ndbre/dirtt/Site/Circle_green.png

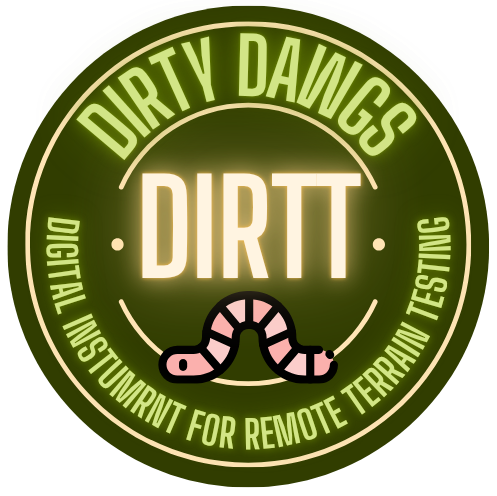
Site/Circle_green.png
