ndbre/dirtt/Site/Circle_blue.png

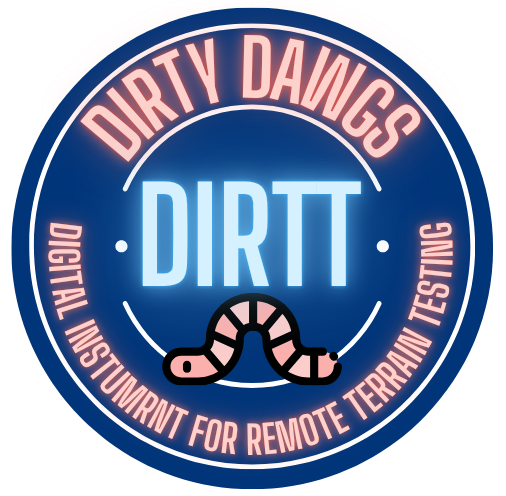
Site/Circle_blue.png
