ndbre/dirtt/PDR/2026-09-12_PDR.pptx

## D.I.R.T.T

Digital Instrument for Remote Terrain Testing

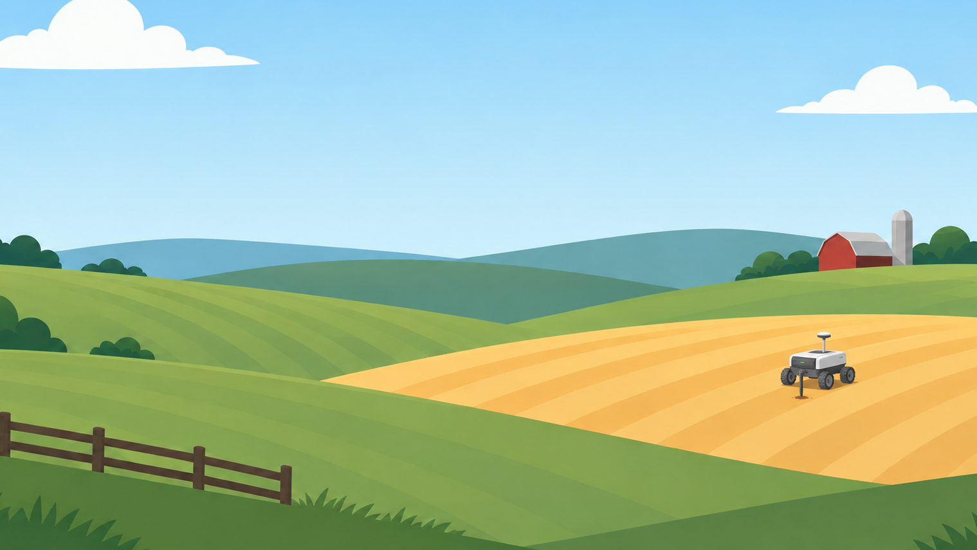
[picture p29: figure]

An affordable, autonomous robot that collects and analyzes soil samples across crop fields.

## Team Members

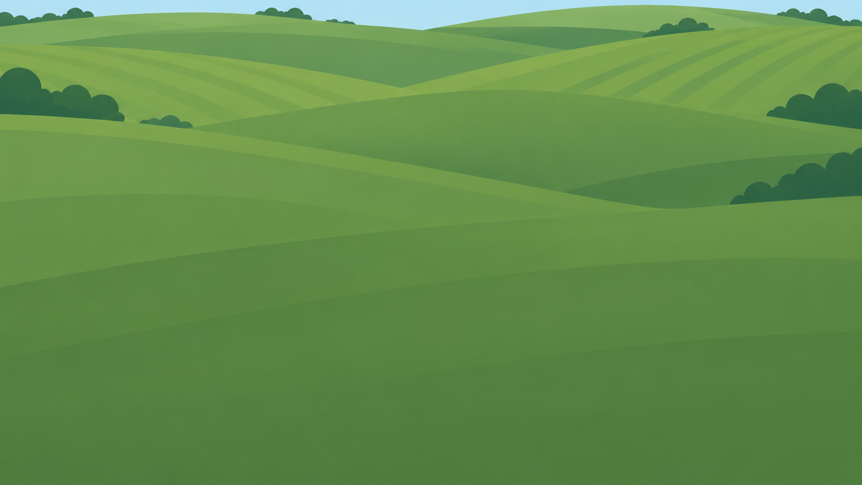
[picture p30: figure]

Nolan Brechtel
Project Manager | Navigation Lead

George Utz
Chief Scientist | Power & Charging Lead

Cara Belew
Data Backup & Control Lead

Zachary Morrow
Soil Testing Lead

Rebecca Ueltschey
Drivetrain Lead

Dr. Chrsitopher Hudson
Faculty Advisor

## The Problem

Who We Help

Agricultural Research Labs
Need affordable, autonomous sampling to reduce technician hours in the field
Independent Farms
Need reliable soil data without the high cost of existing robots
Field Technician
Need to reduce repetitive, manual sampling work

25,000
$41B
49%

people die from every day, including more than 10,000 children [1]

gap between U.S. agricultural imports and exports each [2]

of U.S. crop fields show poor health or nutrient imbalance [3]

## The Problem

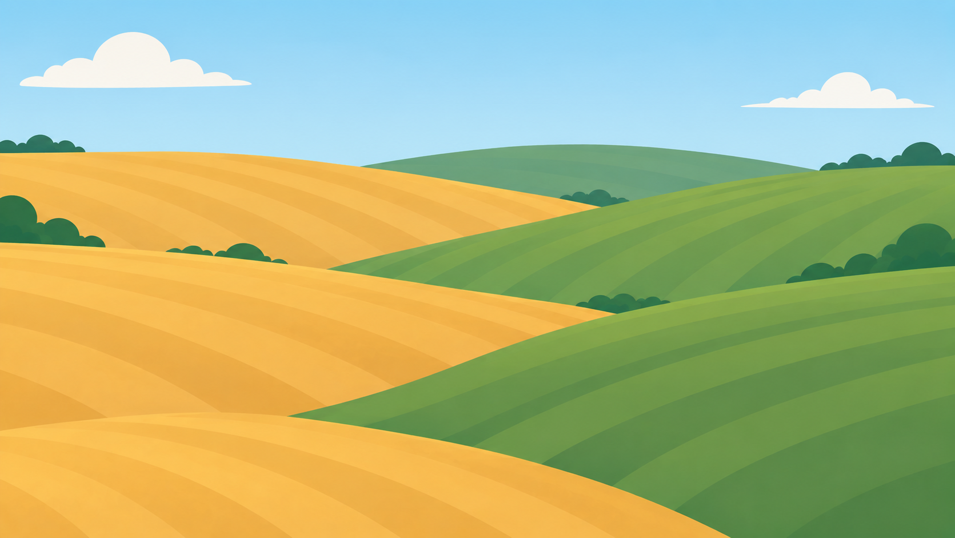
[picture p31: figure]

Who We Help

Agricultural Research Labs
Need affordable, autonomous sampling to reduce technician hours in the field
Independent Farms
Need reliable soil data without the high cost of existing robots
Field Technician
Need to reduce repetitive, manual sampling work

25,000
$41B
49%

people die from every day, including more than 10,000 children [1]

gap between U.S. agricultural imports and exports each [2]

of U.S. crop fields show poor health or nutrient imbalance [3]

## Slide 5
