ndbre/dirtt/PS/2026-09-14_PS.docx

# 1. PROBLEM STATEMENT

Soil health is critical to the growth of healthy crops, and knowing what nutrients are lacking is necessary to correct for deficiencies. D.I.R.T.T. is an autonomous soil testing robot that allows users to understand what they have in their dirt, thereby allowing them to properly address any issues.

## 1.1. Need Statement

Approximately 25,000 people, including more than 10,000 children, die each day from hunger and related causes [1]. In 2025, U.S. agricultural imports exceeded agricultural exports by $41 billion [2]. Meanwhile, farmers reported at least one soil or water resource concern on 49% of surveyed soybean, oat, cotton, and wheat fields [3]. Agricultural soil testing traditionally requires numerous individual soil cores to produce a representative composite sample. Depending on the sampling methodology, extension services generally recommend collecting approximately 10–20 cores from each management area or zone [4]. Improper sampling location, depth, or technique can produce unrepresentative samples and consequently inaccurate soil-test recommendations [5]. The labor required to manually collect these samples creates an opportunity for automated soil-sampling systems to improve sampling consistency and reduce the time personnel spend performing repetitive field collection tasks.

## 1.2. Background and Related Work

Soil health is normally evaluated by measuring nutrient levels, such as NPK and pH. Nutrient sensing relies on ion-selective electrodes (ISEs), while pH is measured using a similar ion-selective electrode immersed in a soil solution. Traditionally, soil testing is done manually, which is slow and labor-intensive across large farmlands. Autonomous systems have been developed to address this: Rogo's SmartCore follows a pre-programmed grid, covering about 500 acres in five hours while reducing sampling variability by at least 10% [6], [7]. Agrobot Lala uses satellite imagery and AI to select sampling zones, then autonomously extracts and analyzes each sample for nitrates on-site in about 30 minutes [8].

The needed device shares values with both systems: autonomous, GPS-guided navigation to sampling locations, but differs in how it divides the work and how it's powered. Rogo demonstrates fast, reliable autonomous sampling, but all analysis is done in an off-site lab and runs on diesel [6], while Lala demonstrates in-field analysis but at a slower pace [8]. This project design combines navigation, sampling, and on-board analysis in a single solar-powered unit, positioning it as a lower-cost, fuel-independent alternative that avoids emissions, refueling, and operating costs of larger vehicles. Existing designs, such as ISE-based nitrate probes with protective membranes for field insertion [9], [11], and multi-ion electrode arrays with defined response times and service life [10], establish practical approaches that may be helpful for this design.

Together, this research confirms that both autonomous navigation and in-field nutrient sensing are established approaches. The next section translates these findings into concrete Design Requirement Specifications, defining the specific performance, sampling, analysis, and power criteria the device must meet.

## References

[1] United Nations, "Losing 25,000 to hunger every day," UN Chronicle, vol. 45, no. 2–3, Jun. 2008. [Online]. Available: https://www.un.org/en/chronicle/article/losing-25000-hunger-every-day

[2] USDA Economic Research Service, "U.S. agricultural import values outpaced export values in 2025," USDA ERS, Jun. 30, 2026. [Online]. Available: https://www.ers.usda.gov/data-products/chart-gallery/58310

[3] A. B. Rosenberg and S. Wallander, "Farmer-reported soil and water concerns vary by crop type and region," USDA Economic Research Service, Amber Waves, May 6, 2022. [Online]. Available: https://www.ers.usda.gov/amber-waves/2022/may/farmers-report-soil-related-resource-concerns-on-about-half-of-soybean-wheat-cotton-and-oat-fields

[4] NC State Extension, "Soil sampling strategies for site-specific field management," NC State Extension Publications. [Online]. Available: https://content.ces.ncsu.edu/soil-sampling-strategies-for-site-specific-field-management [Accessed: Sep. 14, 2026].

[5] Mississippi State University Extension, "Soil testing for the farmer," Mississippi State University Extension Service. [Online]. Available: https://extension.msstate.edu/publications/soil-testing-for-the-farmer [Accessed: Sep. 14, 2026].

[6] B. Barker, "Autonomous soil sampling: Robo sampling improves accuracy, "Top Crop Manager, https://www.topcropmanager.com/autonomous-soil-sampling-robo-sampling-improves-accuracy/ (accessed Sep. 14, 2026).

[7] A. Reporters, "Autonomous robots collect soil samples to help reduce fertilizer," AGDAILY, https://www.agdaily.com/technology/robots-soil-samples-fertilizer/ (accessed Sep. 14, 2026).

[8] G. Kitić et al., "Agrobot Lala—an autonomous robotic system for real-time, in-field soil sampling, and analysis of nitrates," Sensors, vol. 22, no. 11, p. 4207, May 2022. Doi:10.3390/s22114207

[9] J. Andrews, A. Biswas, and J. Huang, "Apparatus and method for direct nitrate sensing in soil," U.S. Patent Application 2025/0180537, filed Nov. 30, 2023.

[10] A. V. Skotnikov and V. A. Bobrov, "Automated work station for analyzing soil samples," U.S. Patent 5,526,705, assigned to Tyler Limited Partnership, Jun. 18, 1996.

[11] T. Miller, P.-H. Le Besnerais, and H. Malaurie, "Soil chemistry sensor," U.S. Patent 9,733,206, assigned to Plant Biosciences Limited, Aug. 15, 2017.

ECE 4512 Design I Sept. 21, 2026
