ndbre/dirtt/Cats/Becca_Cat.png

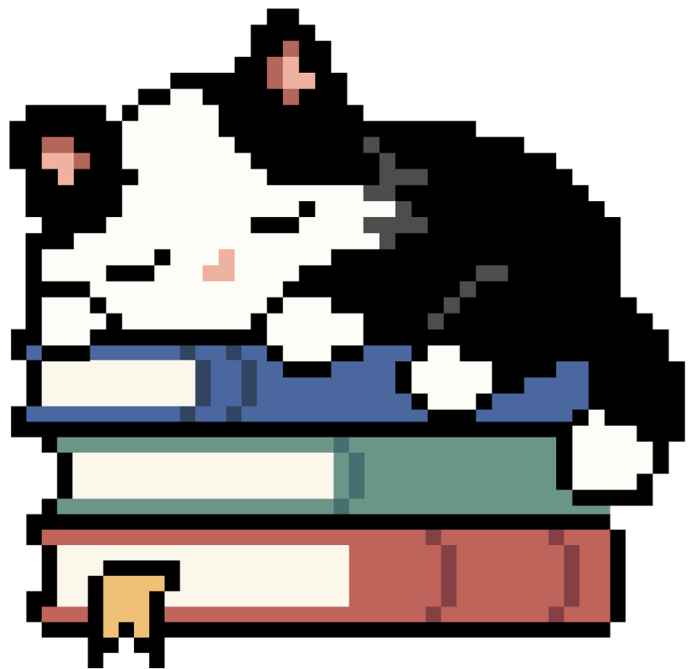
Cats/Becca_Cat.png
