ndbre/dirtt/Cats/Cara_Cat.png

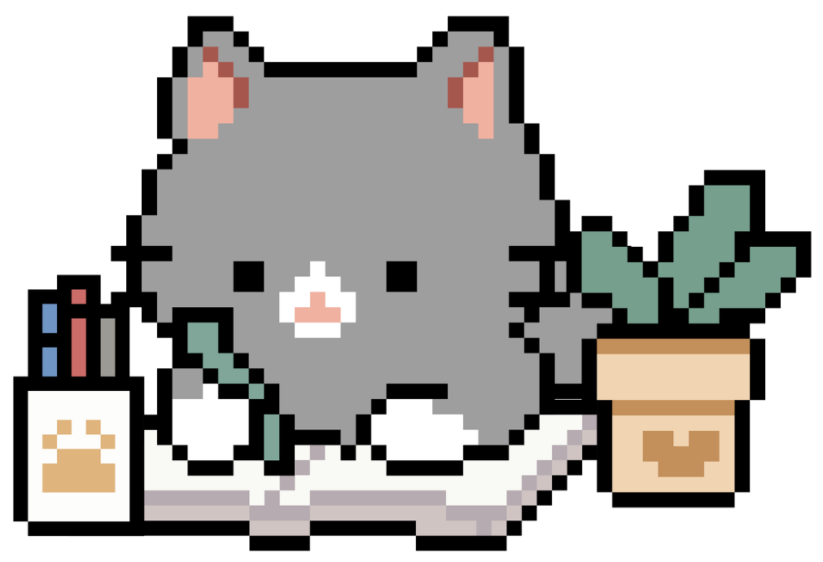
Cats/Cara_Cat.png
