ndbre/dirtt/Cats/George_Cat.png

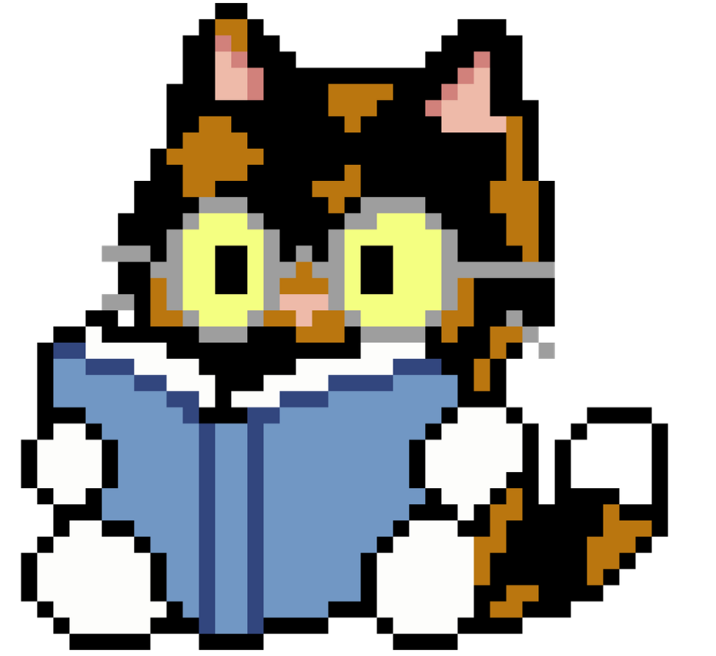
Cats/George_Cat.png
