ndbre/dirtt/Cats/Nolan_Cat.png

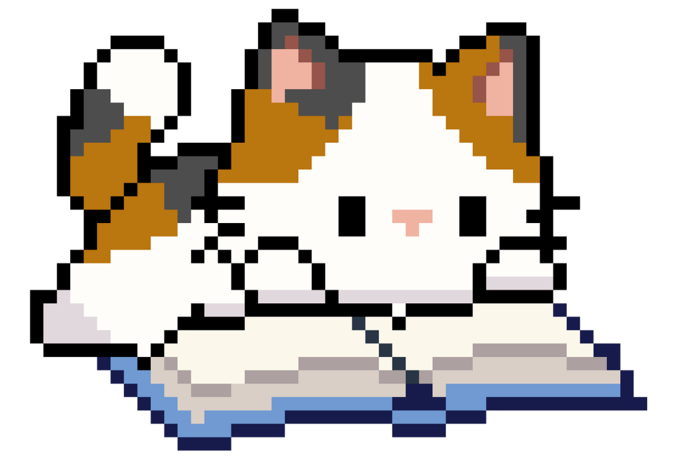
Cats/Nolan_Cat.png
