ndbre/dirtt/Cats/Zac_Cat.png

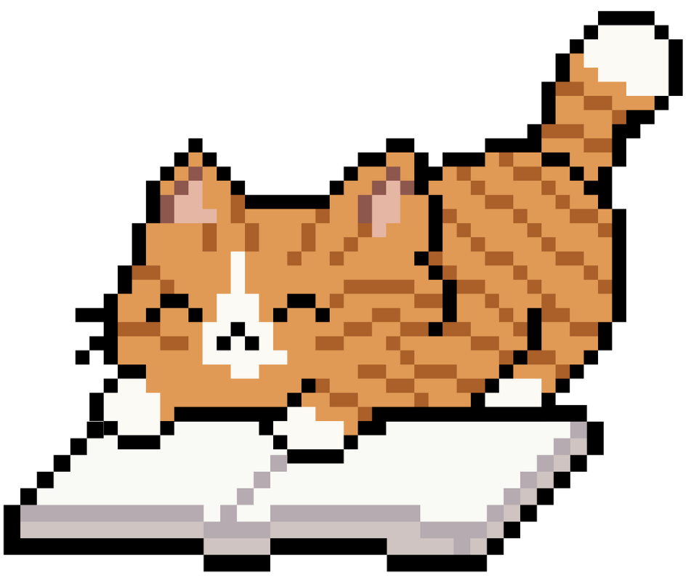
Cats/Zac_Cat.png
