ndbre/dirtt/Site/Circle_red.png

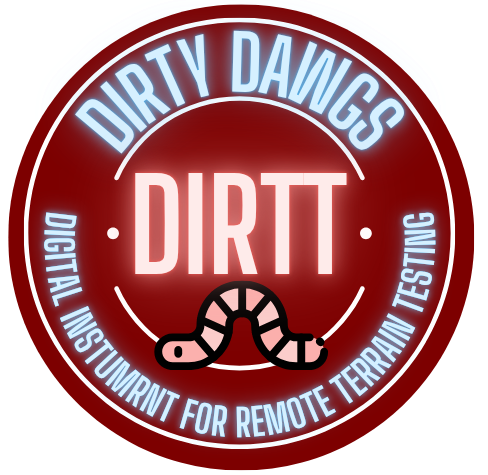
Site/Circle_red.png
