ndbre/dirtt/Site/DIRTT.png

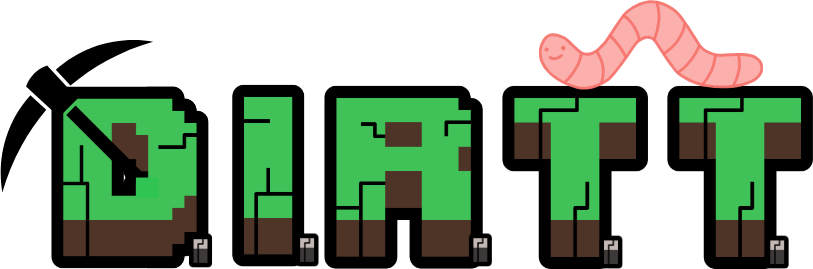
Site/DIRTT.png
