ndbre/dirtt/Site/Home1.png

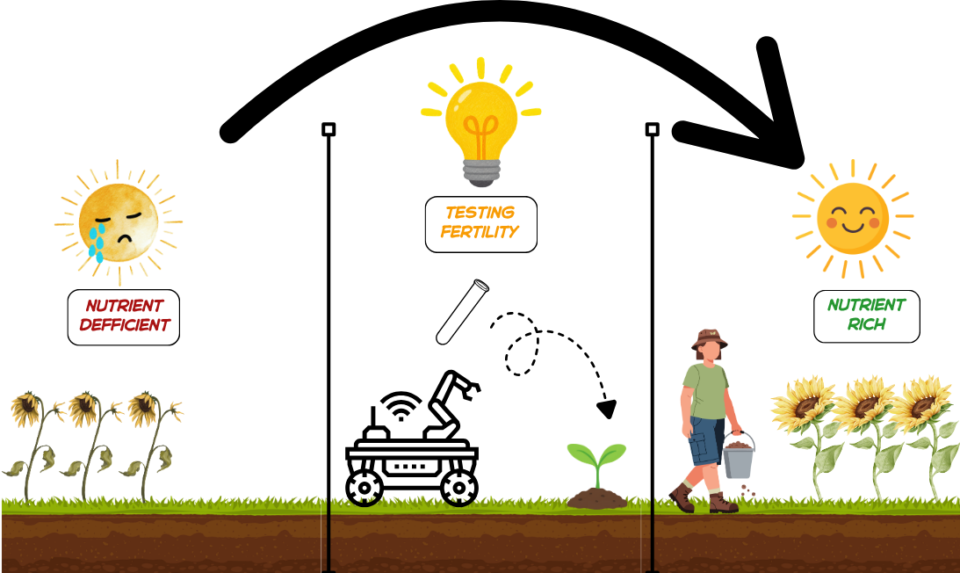
Site/Home1.png
