ndbre/dirtt/Site/Square_blue.png

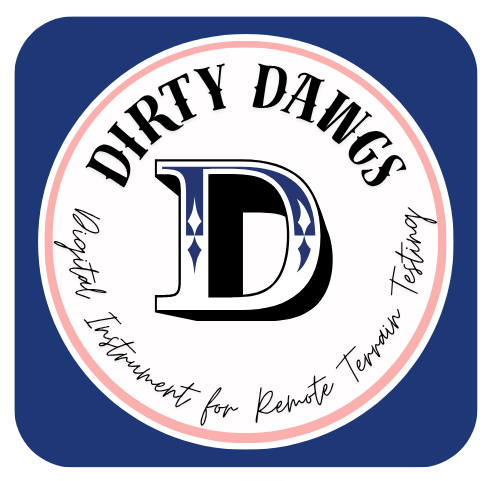
Site/Square_blue.png
