ndbre/dirtt/Site/Square_green.png

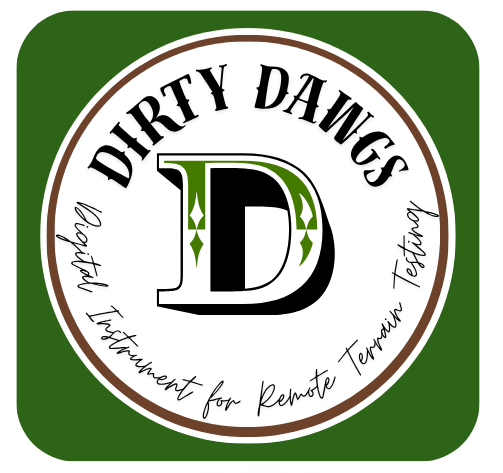
Site/Square_green.png
