ndbre/dirtt/Site/Square_red.png

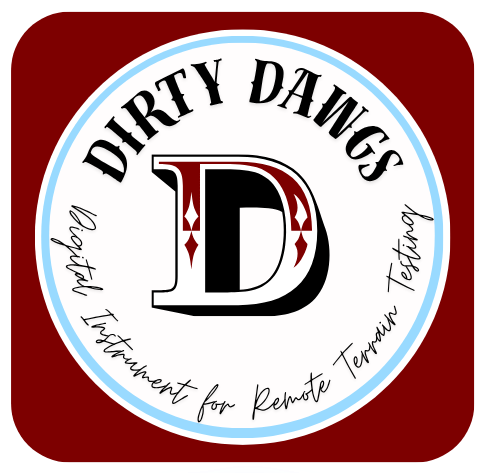
Site/Square_red.png
