ndbre/dirtt/Devlog/2026-09-30/Parts Ordered.xlsx

Item | Qty | Price per | Total | Link
Raspberry Pi Zero 2 W with Header | 2 | $20.75 | $41.50 | https://www.pishop.us/product/raspberry-pi-zero-2w-with-headers/
TOPESEL 32GB(The Actual Usable Capacity is 28.8GB) Micro SD Card 2 Pack Memory Cards MicroSDHC UHS-I TF Card Class 10(32GB 2Pack) | 1 | $19.85 | $19.85 | https://a.co/d/01XdBOQl
Adafruit LoRa Radio Bonnet with OLED - RFM95W @ 915MHz - RadioFruit | 2 | $32.50 | $65.00 | https://www.adafruit.com/product/4074
Antenna | 1 | $10.98 | $10.98 | https://a.co/d/00T0kell
Soil Sensor | 1 | $69.00 | $69.00 | https://www.dfrobot.com/product-2830.html
Industrial USB to RS485 Bidirectional Converter | 1 | $10.99 | $10.99 | https://www.waveshare.com/usb-to-rs485.htm
USB OTG Host Cable - MicroB OTG male to A female | 1 | $2.50 | $2.50 | https://www.adafruit.com/product/1099
