ndbre/dirtt/Files/Drivetrain Motor FIT0185.stl

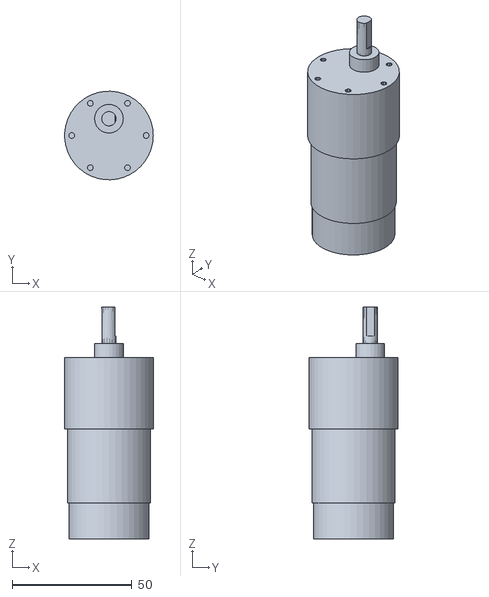
[picture p55: CAD file, 2026-09-29]
Files/Drivetrain Motor FIT0185.stl
36.9 x 37.0 x 96.8
