ndbre/dirtt/(commit log)

2026-09-29 Added files tab
    [Drivetrain Motor FIT0185.stl]
2026-09-30 Devlog update
    [Parts Ordered.xlsx]
